Supercookiegaming/M.2-to-USB/README.md

# M.2-to-USB Adapter Card

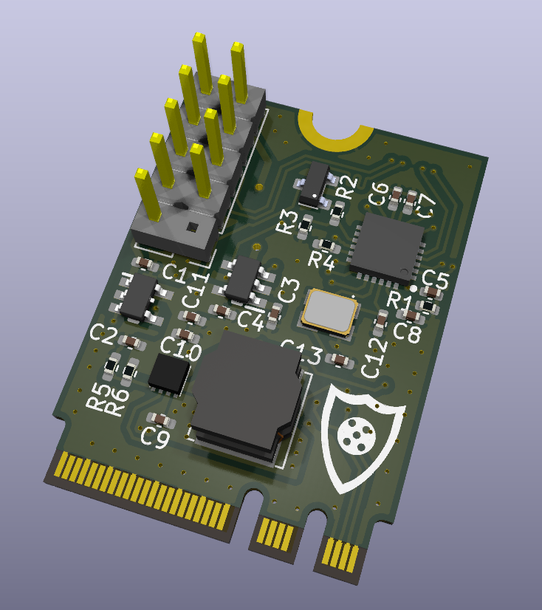
[picture p1: Renders/3D/M.2 to USB 3D Render.PNG]


[logo]: https://github.com/Supercookiegaming/M.2-to-USB/blob/main/Renders/3D/M.2%20to%20USB%203D%20Render.PNG

The M.2 to USB adapater uses the single USB 2.0 port on the A/E Key M.2 slot to make an USB front panel connector. The board uses the Microchip USB2422 2 port USB 2.0 hub IC. The hub allows 2 usb ports to be connected to the single port on the M.2 slot. This board is designed to handle 0.5 A per USB port, above that current the port will turn off. This was done because the M.2 slot can only provide 6.6 W. The 5V rail is made from the 3.3V found on the M.2 slot via a boost converter. 

The board was designed to compatible with OSH Park's 2 layer 0.8mm thick PCB service. 

The board is free to use for personal use only.
