Supercookiegaming/M.2-to-USB/Renders/2D/M.2 to USB 2D Render.PNG

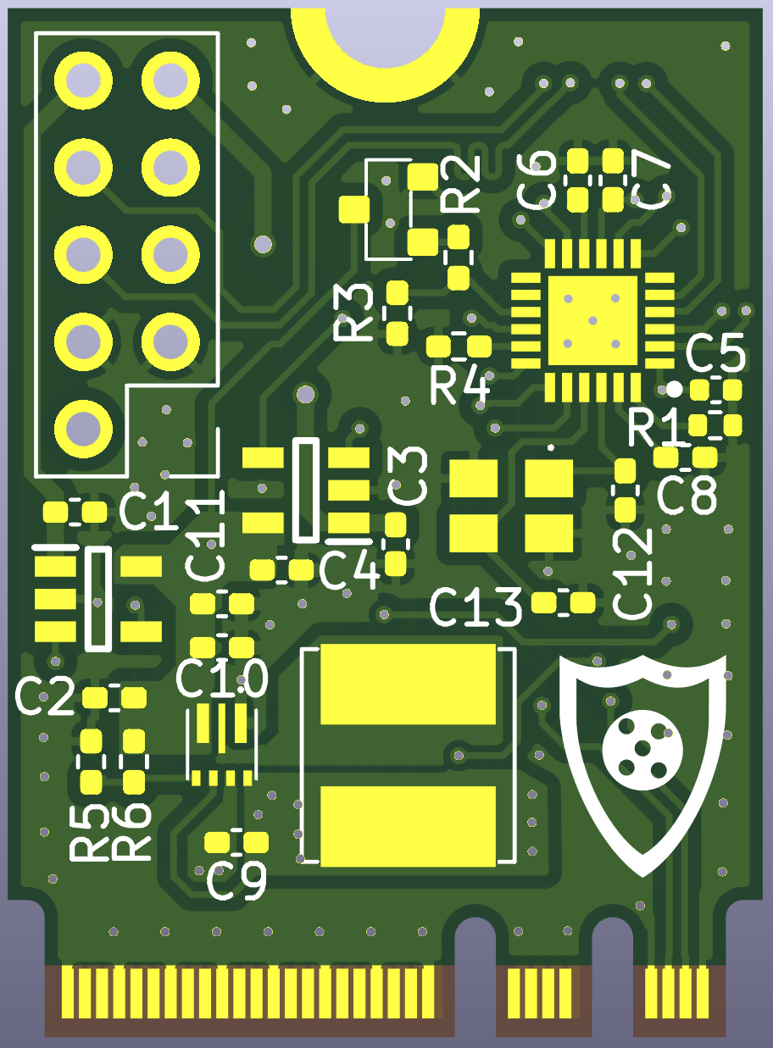
Renders/2D/M.2 to USB 2D Render.PNG
