Supercookiegaming/M.2-to-USB/BOM/BOM M.2 to USB V1.0.xlsx

Board QTY | 1
Total Price | 9.7
Board Designator | Part Number | Part Purpose | QTY per Board | Unit Price | QTY Needed | Total Price | Link
L1 | SRN6045TA-1R0Y | Boost Converter Inductor | 1 | 0.45 | 1 | 0.45 | https://www.digikey.com/en/products/detail/bourns-inc/SRN6045TA-1R0Y/6155099
U1 | APX809-46SRG-7 | Reset Signal Handler | 1 | 0.57 | 1 | 0.57 | https://www.digikey.com/en/products/detail/diodes-incorporated/APX809-46SRG-7/1844682
IC1 | USB2422T_MJ | USB 2.0 Hub | 1 | 1.58 | 1 | 1.58 | https://www.digikey.com/en/products/detail/microchip-technology/USB2422T-MJ/4080184
IC2, IC3 | TPS2041CDBVT | USB Current Limiter | 2 | 1.14 | 2 | 2.28 | https://www.digikey.com/en/products/detail/texas-instruments/tps2041cdbvt/3778698
PS1 | TPS61022RWUR | 3.3 to 5.0 Boost Converter | 1 | 1.67 | 1 | 1.67 | https://www.digikey.com/en/products/detail/texas-instruments/tps61022rwur/10434777
R1 | ERA-2AEB123X | 12k Hub Bias Resistor | 1 | 0.1 | 1 | 0.1 | https://www.digikey.com/en/products/detail/panasonic-electronic-components/ERA-2AEB123X/1706031
R2, R3, R4, R5 | ERJ-2RKF1003X | 100k pullup and divider Resistor | 4 | 0.1 | 4 | 0.4 | https://www.digikey.com/en/products/detail/panasonic-electronic-components/ERJ-2RKF1003X/192081
R6 | RC0402FR-07732KL | 732k Divider Resistor | 1 | 0.1 | 1 | 0.1 | https://www.digikey.com/en/products/detail/yageo/RC0402FR-07732KL/5281084
C1, C3, C10, C11 | CL05A106MP5NUNC | 10uF Filter Capacitor | 4 | 0.08 | 4 | 0.32 | https://www.digikey.com/en/products/detail/samsung-electro-mechanics/CL05A106MP5NUNC/3887108
C2, C4, C5, C8 | CC0402JRX7R7BB104 | 100nF Filter Capacitor | 4 | 0.08 | 4 | 0.32 | https://www.digikey.com/en/products/detail/yageo/CC0402JRX7R7BB104/5195085
C6, C7 | GRM155Z71A105KE01J | 1uF Filter Capacitor | 2 | 0.1 | 2 | 0.2 | https://www.digikey.com/en/products/detail/murata-electronics/GRM155Z71A105KE01J/16033607
C9 | LMK105BJ225KV-F | 2.2uF Filter Cap | 1 | 0.1 | 1 | 0.1 | https://www.digikey.com/en/products/detail/taiyo-yuden/LMK105BJ225KV-F/7403747
C12 | KGM05ACG1H4R7DH | 4.7pF Crystal Load Cap | 1 | 0.1 | 1 | 0.1 | https://www.digikey.com/en/products/detail/kyocera-avx/KGM05ACG1H4R7DH/1597496
C13 | GJM1555C1H4R5WB01D | 4.5pF Crystal Load Cap | 1 | 0.14 | 1 | 0.14 | https://www.digikey.com/en/products/detail/murata-electronics/GJM1555C1H4R5WB01D/2593001
J2 | TSW-105-07-G-D-010 | Front Panel USB 2.0 Header | 1 | 1.37 | 1 | 1.37 | https://www.digikey.com/en/products/detail/samtec-inc/TSW-105-07-G-D-010/7865193
