Supercookiegaming/M.2-to-USB/KiCad Files/M.2 to USB V1.0/Component Library/G821EU210AAL10Y.stp

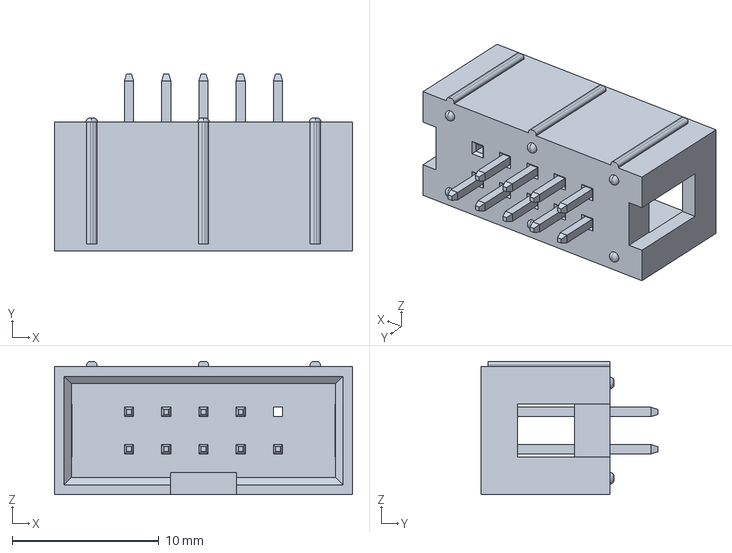
[picture p3: CAD file, 2025-04-17]
KiCad Files/M.2 to USB V1.0/Component Library/G821EU210AAL10Y.stp
20.3 x 12.1 x 9.10 mm
