Supercookiegaming/M.2-to-USB/KiCad Files/M.2 to USB V1.0/Component Library/TSW-105-07-G-D-010.stp

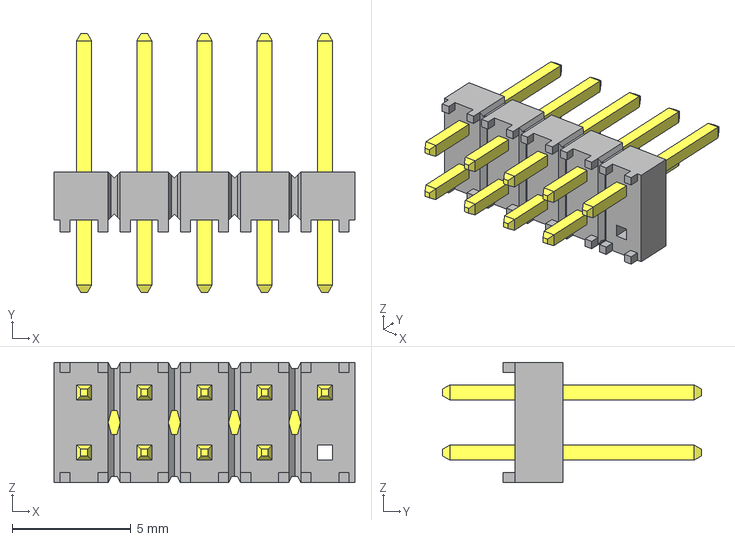
[picture p4: CAD file, 2025-04-17]
KiCad Files/M.2 to USB V1.0/Component Library/TSW-105-07-G-D-010.stp
12.7 x 10.9 x 5.08 mm
TSW-105-07-G-D-010_body
T-1S6-07-TSW-1-07-5-D-010
