Supercookiegaming/M.2-to-USB/KiCad Files/M.2 to USB V1.0/Component Library/RH100-24.000-9-1015-EXT-TR.stp

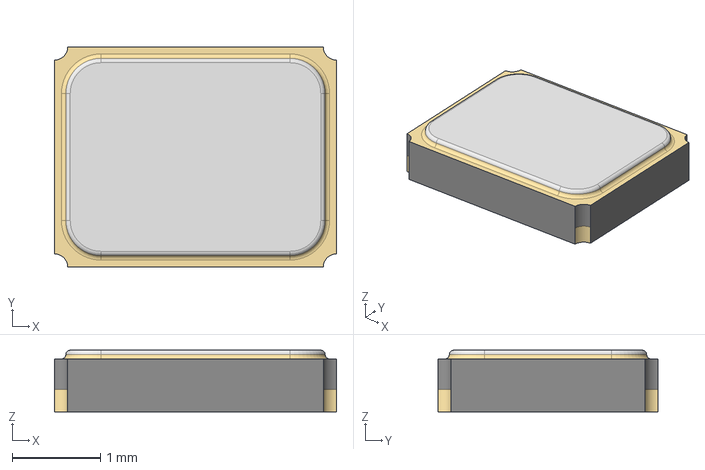
[picture p5: CAD file, 2025-04-17]
KiCad Files/M.2 to USB V1.0/Component Library/RH100-24.000-9-1015-EXT-TR.stp
3.20 x 2.50 x 0.7 mm
