Supercookiegaming/M.2-to-USB/KiCad Files/M.2 to USB V1.0/Component Library/TPS2041CDBVT.stp

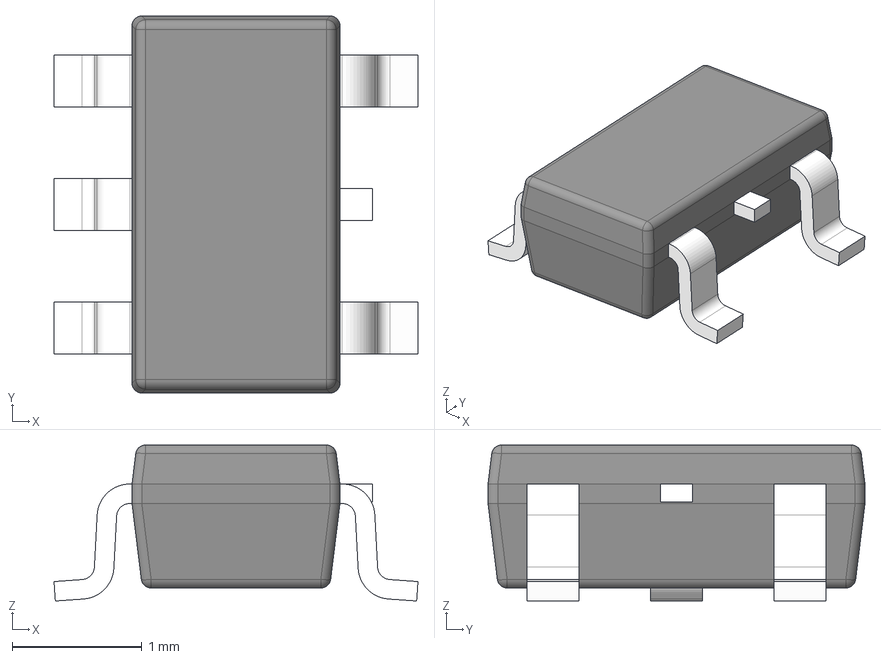
[picture p6: CAD file, 2025-04-17]
KiCad Files/M.2 to USB V1.0/Component Library/TPS2041CDBVT.stp
2.80 x 2.90 x 1.20 mm
BODY-SOT
LEAD-SOT x 5
LEAD-DUMMY
