Supercookiegaming/M.2-to-USB/KiCad Files/M.2 to USB V1.0/Component Library/APX809-46SRG-7.step

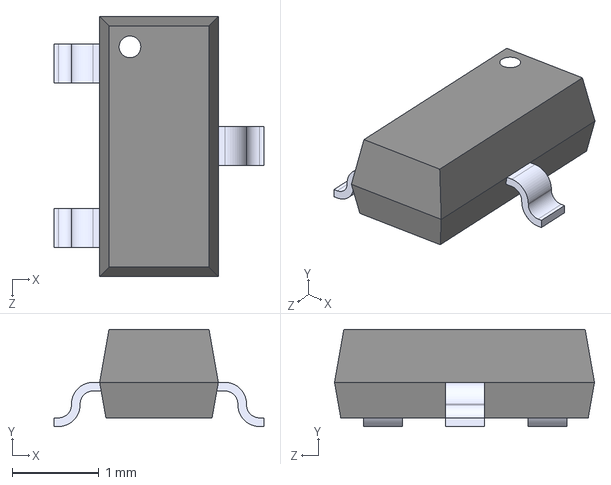
[picture p7: CAD file, 2025-04-17]
KiCad Files/M.2 to USB V1.0/Component Library/APX809-46SRG-7.step
2.42 x 1.12 x 3.00 mm
