Supercookiegaming/M.2-to-USB/KiCad Files/M.2 to USB V1.0/Component Library/USB2422T_MJ.stp

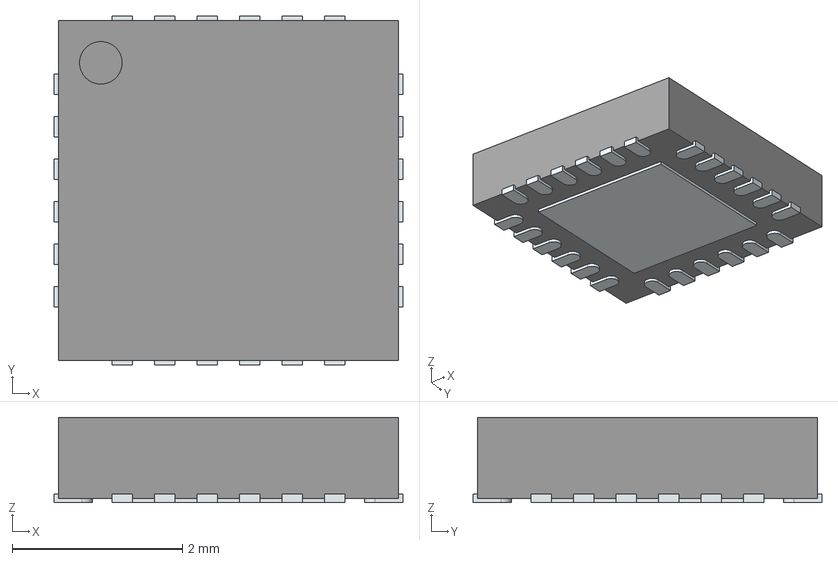
[picture p8: CAD file, 2025-04-17]
KiCad Files/M.2 to USB V1.0/Component Library/USB2422T_MJ.stp
4.10 x 4.10 x 1.00 mm
ThermalPin
PinsArrayLR
PinsArrayTB
