Supercookiegaming/M.2-to-USB/KiCad Files/M.2 to USB V1.0/Component Library/TPS61022RWUR.stp

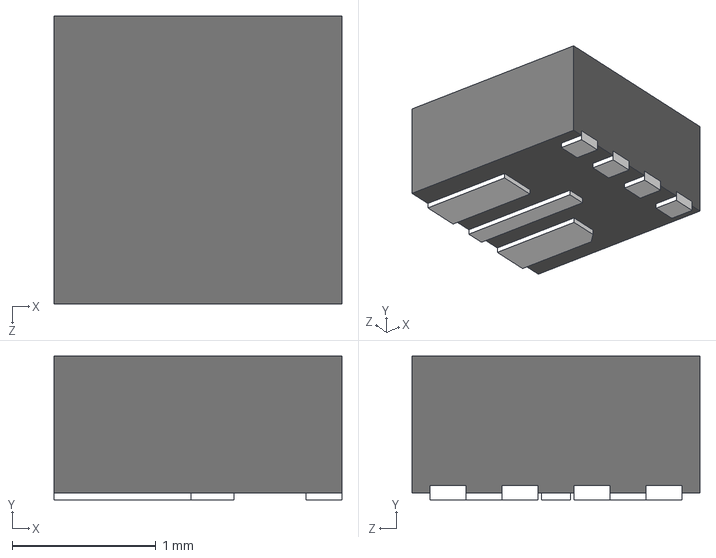
[picture p9: CAD file, 2025-04-17]
KiCad Files/M.2 to USB V1.0/Component Library/TPS61022RWUR.stp
2.00 x 1.00 x 2.00 mm
