Supercookiegaming/M.2-to-USB/Schematic/Schematic M.2 to USB V1.0.pdf

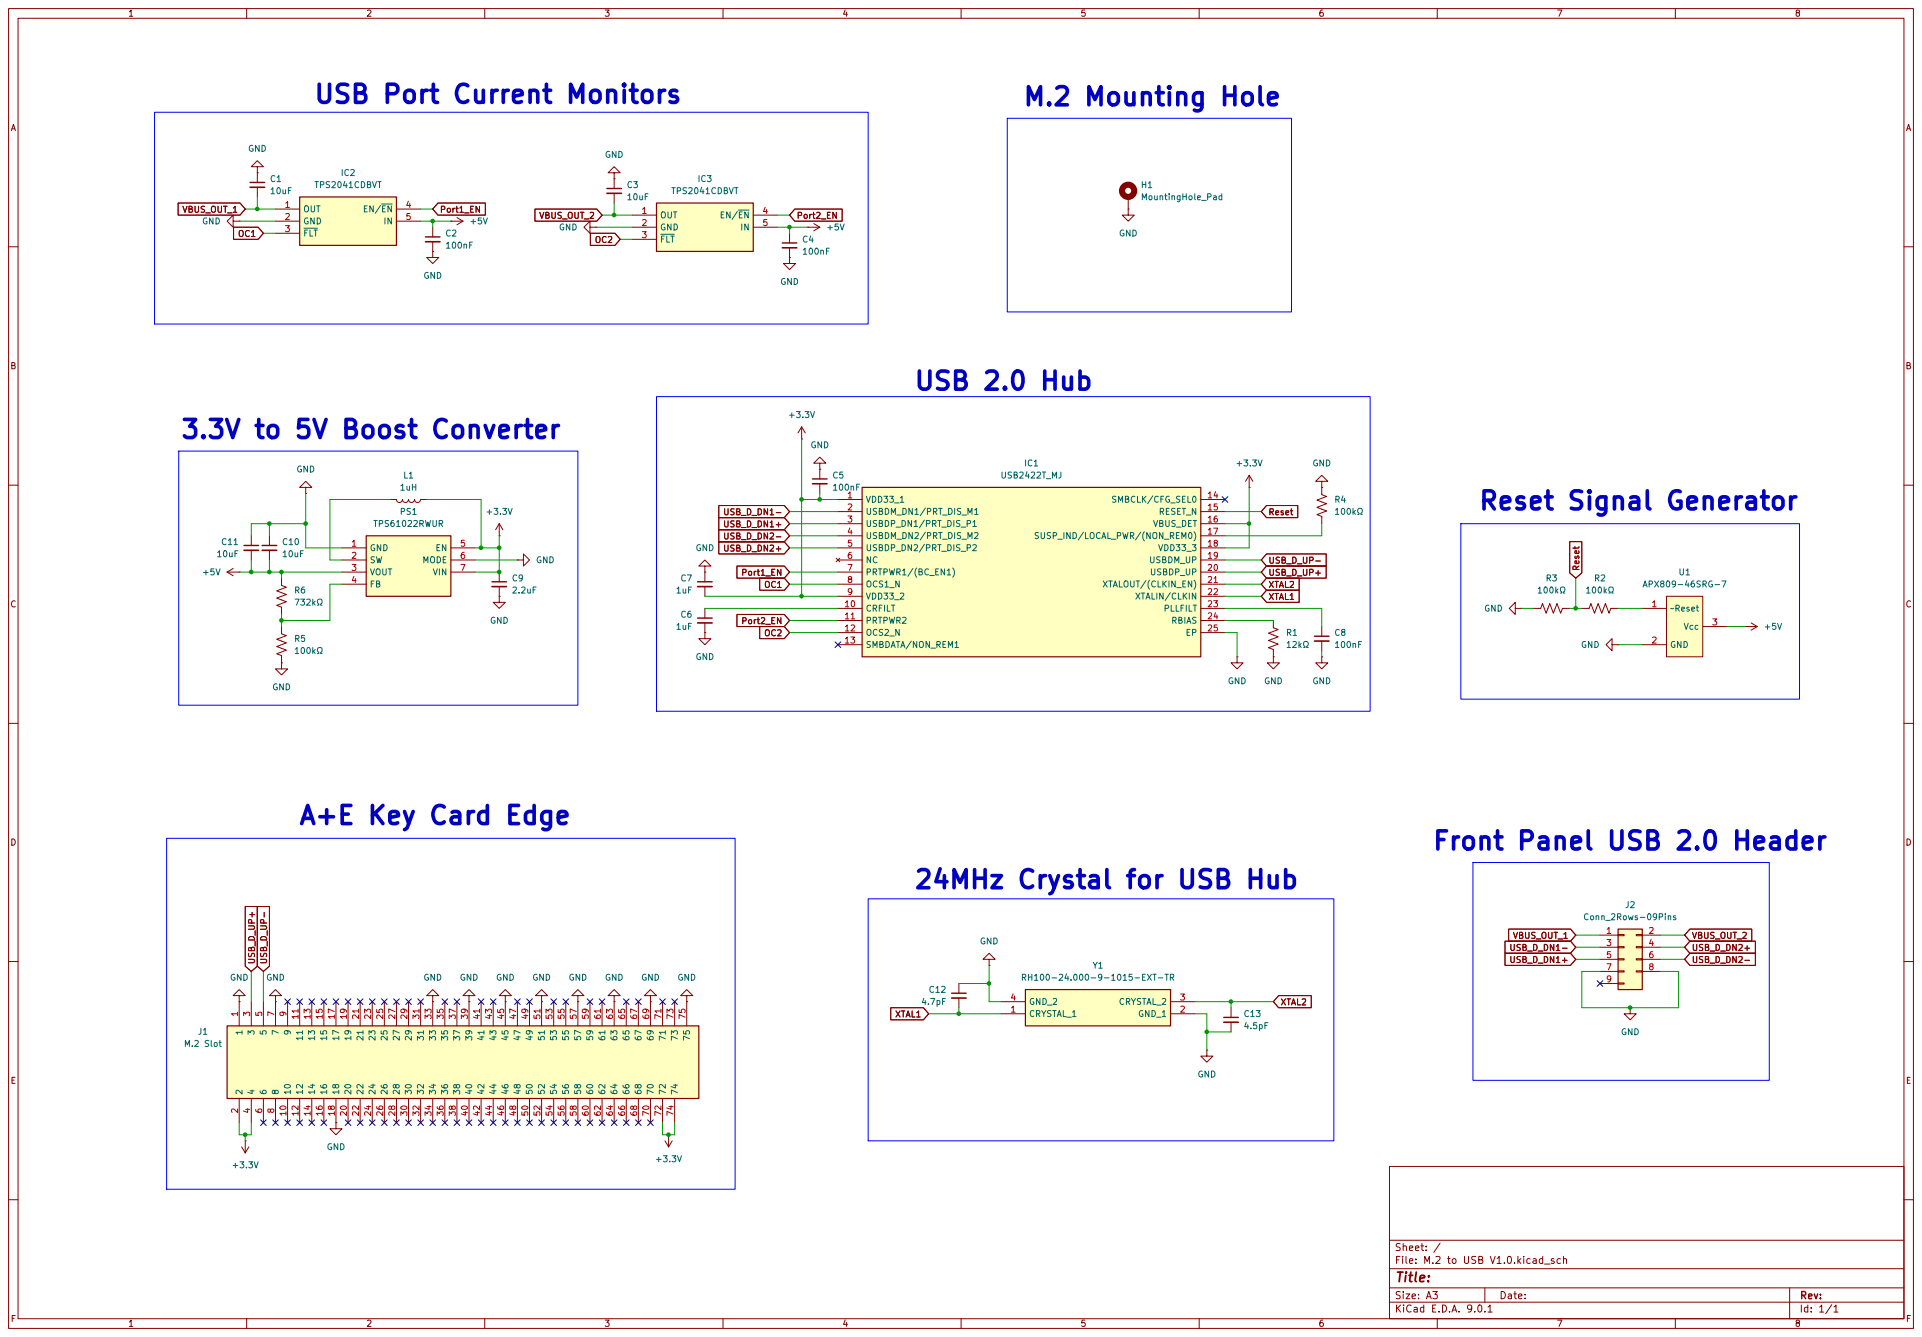
[picture p10: page 1]
