Supercookiegaming/M.2-to-USB/KiCad Files/M.2 to USB V1.0/M.2 to USB V1.0.kicad_pcb

## KiCad design KiCad Files/M.2 to USB V1.0/M.2 to USB V1.0.kicad_pcb (2025-04-19)

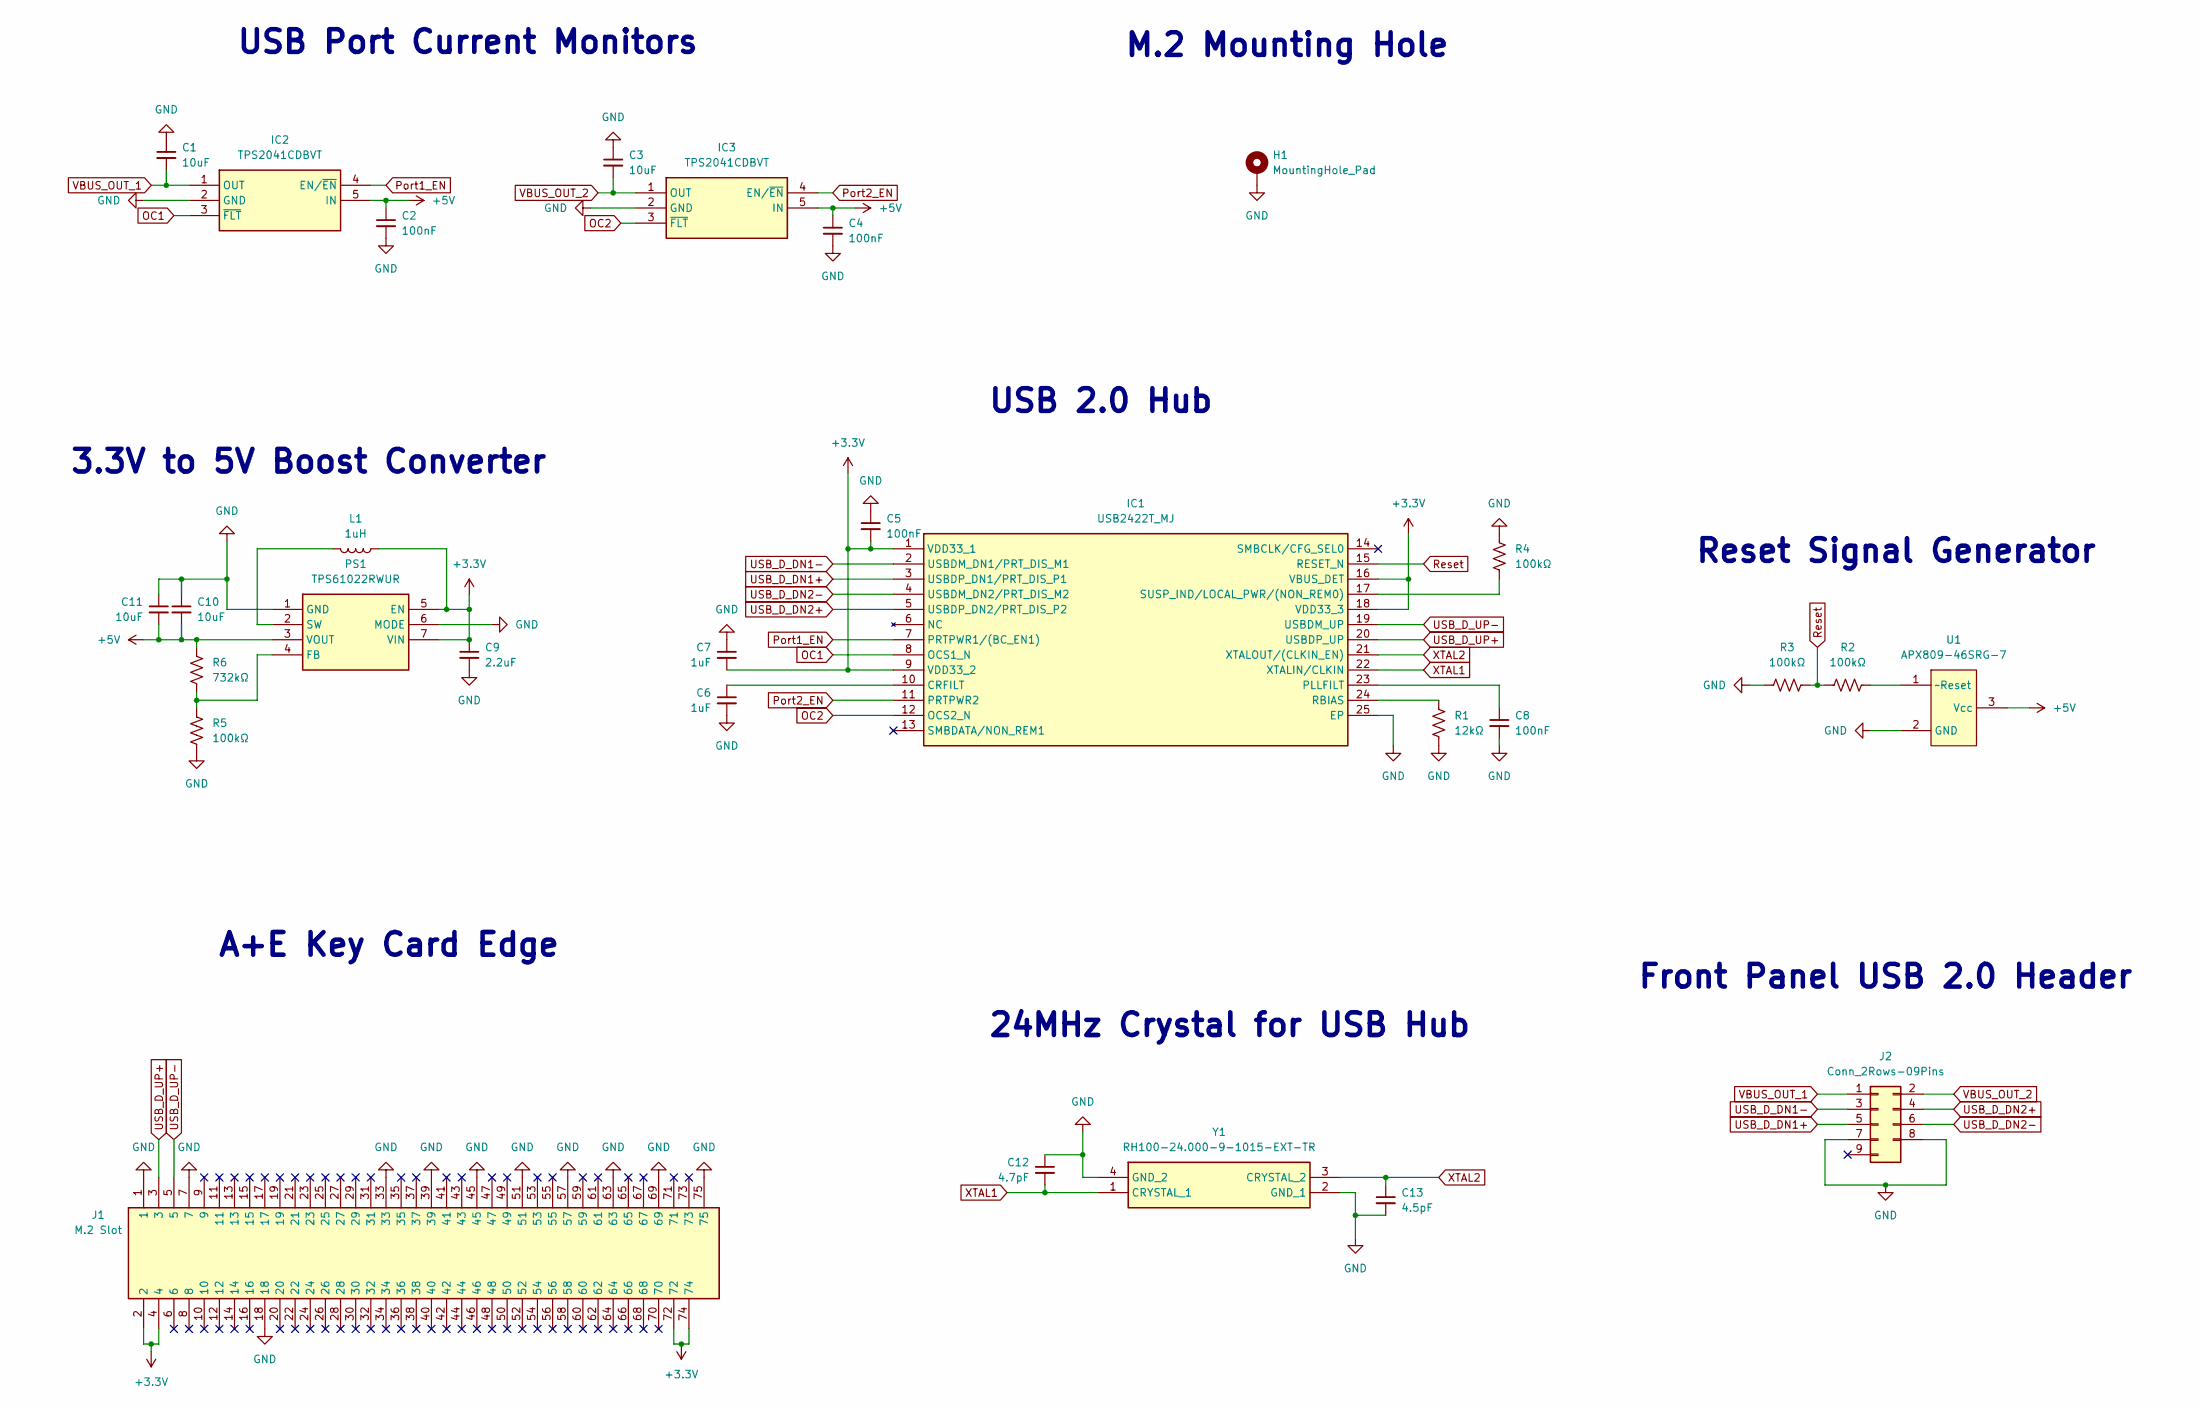
[picture p11: schematic M.2 to USB V1.0.kicad_sch]

Parts:
C1, C3, C10, C11: 10uF; C_0402_1005Metric_Pad0.74x0.62mm_HandSolder
C2, C4, C8: 100nF; C_0402_1005Metric_Pad0.74x0.62mm_HandSolder
C5: 100nF; C_0402_1005Metric
C6, C7: 1uF; C_0402_1005Metric_Pad0.74x0.62mm_HandSolder
C9: 2.2uF; C_0402_1005Metric_Pad0.74x0.62mm_HandSolder
C12: 4.7pF; C_0402_1005Metric_Pad0.74x0.62mm_HandSolder
C13: 4.5pF; C_0402_1005Metric_Pad0.74x0.62mm_HandSolder
H1: MountingHole_Pad; m.2 edge mount hole
IC1: USB2422T_MJ; QFN50P400X400X100-25N-D; Manufacturer_Part_Number USB2422T/MJ; Mouser Part Number 579-USB2422T/MJ
IC2, IC3: TPS2041CDBVT; SOT95P280X145-5N; Manufacturer_Part_Number TPS2041CDBVT; Mouser Part Number 595-TPS2041CDBVT
J1: M.2 Slot; NGFF_A+E; Manufacturer_Part_Number MDT420E03001; Mouser Part Number 523-MDT420E03001
J2: Conn_2Rows-09Pins; USB 2.0 Front Header
L1: 1uH; L_Bourns_SRN6045TA
PS1: TPS61022RWUR; Manufacturer_Part_Number TPS61022RWUR; Mouser Part Number 595-TPS61022RWUR
R1: 12kΩ; R_0402_1005Metric
R2, R3, R4, R5: 100kΩ; R_0402_1005Metric_Pad0.72x0.64mm_HandSolder
R6: 732kΩ; R_0402_1005Metric_Pad0.72x0.64mm_HandSolder
U1: APX809-46SRG-7; APX809-SR
Y1: RH100-24.000-9-1015-EXT-TR; RH10010000105050TR; Manufacturer_Part_Number RH100-24.000-9-1015-EXT-TR

Connections:
+3.3V: C5.2, C7.2, C9.1, IC1.1 (VDD33_1), IC1.9 (VDD33_2), IC1.16 (VBUS_DET), IC1.18 (VDD33_3), J1.2, J1.4, J1.72, J1.74, L1.1, PS1.5 (EN), PS1.7 (VIN)
+5V: C2.1, C4.1, C10.2, C11.2, IC2.5 (IN), IC3.5 (IN), PS1.3 (VOUT), R6.1, U1.3 (Vcc)
GND: C1.1, C2.2, C3.1, C4.2, C5.1, C6.2, C7.1, C8.2, C9.2, C10.1, C11.1, C12.1, C13.2, H1.1, IC1.25 (EP), IC2.2 (GND), IC3.2 (GND), J1.1, J1.7, J1.18, J1.33, J1.39, J1.45, J1.51, J1.57, J1.63, J1.69, J1.75, J2.7, J2.8, PS1.1 (GND), PS1.6 (MODE), R1.2, R3.2, R4.2, R5.2, U1.2 (GND), Y1.2 (GND_1), Y1.4 (GND_2)
unnamed: C6.1, IC1.10 (CRFILT)
unnamed: C8.1, IC1.23 (PLLFILT)
unnamed: IC1.24 (RBIAS), R1.1
unnamed: IC1.17 (SUSP_IND/LOCAL_PWR/(NON_REM0)), R4.1
unnamed: PS1.4 (FB), R5.1, R6.2
unnamed: L1.2, PS1.2 (SW)
unnamed: R2.1, U1.1 (~Reset)
OC1: IC1.8 (OCS1_N), IC2.3 (~FLT)
OC2: IC1.12 (OCS2_N), IC3.3 (~FLT)
Port1_EN: IC1.7 (PRTPWR1/(BC_EN1)), IC2.4 (EN/~EN)
Port2_EN: IC1.11 (PRTPWR2), IC3.4 (EN/~EN)
Reset: IC1.15 (RESET_N), R2.2, R3.1
USB_D_DN1+: IC1.3 (USBDP_DN1/PRT_DIS_P1), J2.5
USB_D_DN1-: IC1.2 (USBDM_DN1/PRT_DIS_M1), J2.3
USB_D_DN2+: IC1.5 (USBDP_DN2/PRT_DIS_P2), J2.4
USB_D_DN2-: IC1.4 (USBDM_DN2/PRT_DIS_M2), J2.6
USB_D_UP+: IC1.20 (USBDP_UP), J1.3
USB_D_UP-: IC1.19 (USBDM_UP), J1.5
VBUS_OUT_1: C1.2, IC2.1 (OUT), J2.1
VBUS_OUT_2: C3.2, IC3.1 (OUT), J2.2
XTAL1: C12.2, IC1.22 (XTALIN/CLKIN), Y1.1 (CRYSTAL_1)
XTAL2: C13.1, IC1.21 (XTALOUT/(CLKIN_EN)), Y1.3 (CRYSTAL_2)

Notes on the sheet:
3.3V to 5V Boost Converter
24MHz Crystal for USB Hub
A+E Key Card Edge
USB 2.0 Hub
Reset Signal Generator
M.2 Mounting Hole
USB Port Current Monitors
Front Panel USB 2.0 Header

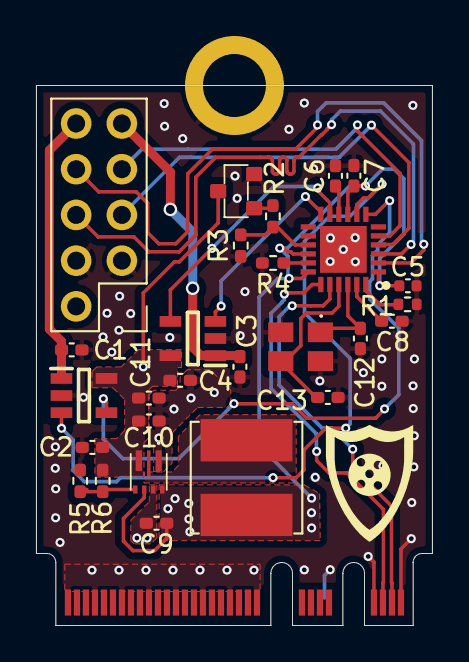
[picture p12: board M.2 to USB V1.0.kicad_pcb from above]

Board: 2 copper layers, 22.0 x 30.0 mm, 29 parts (0 on the bottom side), 25 nets.
