Supercookiegaming/M.2-to-USB/(threads)

Thread 1 (2025-06-13):

Not Enough Capacitance for VBUS Output

Supercookiegaming, 2025-06-13:
USB 2.0 Specification 7.2.4.1 all USB hubs must have no less than 120uF of low-ESR capacitance per hub. current design only has 20uF. next revision should have at least 60uF per port.

[usb_20.pdf](https://github.com/user-attachments/files/20733773/usb_20.pdf)

Supercookiegaming, 2025-08-02:
fixed with 52aa65e

Closed 2025-08-02.

Thread 3 (2025-06-13):

M.2 Mounting Hole is not compliant with M.2 Spec

Supercookiegaming, 2025-06-13:
PCI Express M.2 Specification 2.3.5 Figure 17 details the bottom portion of the mounting hole. Bottom plating should be a half oval not a circle as it currently.

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

Supercookiegaming, 2025-08-02:
fixed in 52aa65e

Closed 2025-08-02.

Thread 4 (2025-07-02):

Crystal Oscillator is not in BOM

Supercookiegaming, 2025-07-02:
Crystal Oscillator is not in the BOM

Thread 5 (2025-07-09):

USB Header Keying is wrong

Supercookiegaming, 2025-07-09:
for the usb internal header the keying pin is wrong. pin 9 should not have a pin and pin 10 should have a pin. currently it is swapped.

Supercookiegaming, 2025-08-02:
fixed in commit 52aa65e

Closed 2025-08-02.

Thread 7 (2025-07-10):

Wrong USB current limiters used

Supercookiegaming, 2025-07-10:
the usb2422 has active high enable signal. the TPS2041CDBVT has an active low enable.

Supercookiegaming, 2025-08-02:
changed to dual channel current limiter AP2152SG-13 in 52aa65e

Closed 2025-08-02.
