Supercookiegaming/M.2-to-USB/(commit log)

2025-04-17 Started Work on schematic
    [APX809-46SRG-7.step, M.2 to USB V1.0.kicad_pcb, M.2 to USB V1.0.kicad_sch, TPS2041CDBVT.stp, TPS61230ARNST.stp, USB2422T_MJ.stp]
2025-04-17 updated schematic
    [M.2 to USB V1.0.kicad_sch]
2025-04-17 finished schematic
    finished schematic values of crystal caps not set. will be set after board design
    [BOM M.2 to USB V1.0.xlsx, M.2 to USB V1.0.kicad_sch, RH100-24.000-9-1015-EXT-TR.stp, TPS61022RWUR.stp]
2025-04-17 added all footprints
    [M.2 to USB V1.0.kicad_sch]
2025-04-17 finished pcb layout
    [G821EU210AAL10Y.stp, M.2 to USB V1.0.kicad_pcb, M.2 to USB V1.0.kicad_sch, TSW-105-07-G-D-010.stp]
2025-04-18 updated pcb
    updated pcb
    calculated load caps
    added 3D render
    [M.2 to USB V1.0.kicad_pcb, M.2 to USB V1.0.kicad_sch]
2025-04-18 fixed copper pour bug
    bug caused by this (https://gitlab.com/kicad/code/kicad/-/issues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) caused copper pours to be corrupted. this updated fixes that.
    [M.2 to USB V1.0.kicad_pcb]
2025-04-18 fixed missing ground connection
    pin 18 was not connected to ground net. it is now connected.
    [M.2 to USB V1.0.kicad_pcb]
2025-04-18 Updated BOM
    added all parts to BOM
    [BOM M.2 to USB V1.0.xlsx]
2025-04-18 Organized Schematic
    [M.2 to USB V1.0.kicad_sch]
2025-04-18 Organized files
    [BOM M.2 to USB V1.0.xlsx]
2025-04-19 Added Gerber Files
    [M.2 to USB V1-B_Cu.gbr, M.2 to USB V1-B_Mask.gbr, M.2 to USB V1-B_Paste.gbr, M.2 to USB V1-B_Silkscreen.gbr, M.2 to USB V1-Edge_Cuts.gbr, M.2 to USB V1-F_Cu.gbr, M.2 to USB V1-F_Mask.gbr, M.2 to USB V1-F_Paste.gbr]
2025-04-21 fixed error in BOM
    [BOM M.2 to USB V1.0.xlsx]
2025-07-10 Updating File Structure
    [M.2 to USB.kicad_pcb, M.2 to USB.kicad_sch]
