Supercookiegaming/M.2-to-USB/(notices)

Notices in the files:
KiCad Files/M.2 to USB V1.0/Component Library/TSW-105-07-G-D-010.stp:
author */ ('License CC BY-ND 4.0'),
